liurobinn/Gimbal_Spoon/CAD/Inner_Gimbal.stl

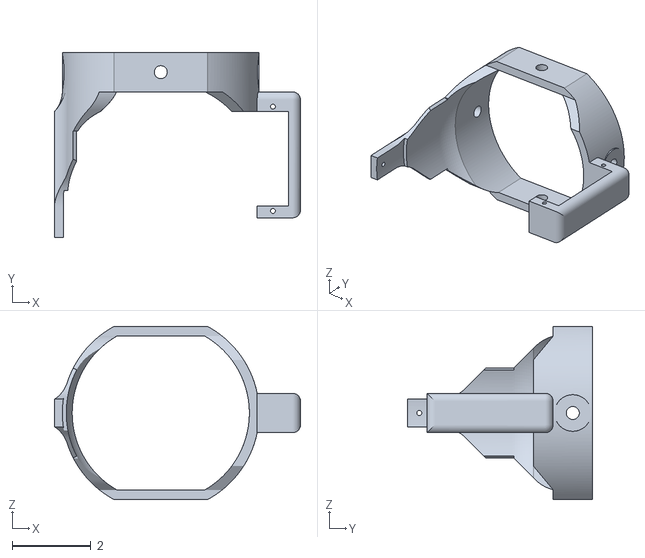
[picture p1: CAD file, 2026-05-01]
CAD/Inner_Gimbal.stl
6.25 x 4.70 x 4.40
