liurobinn/Gimbal_Spoon/CAD/Outer_Gimbal.stl

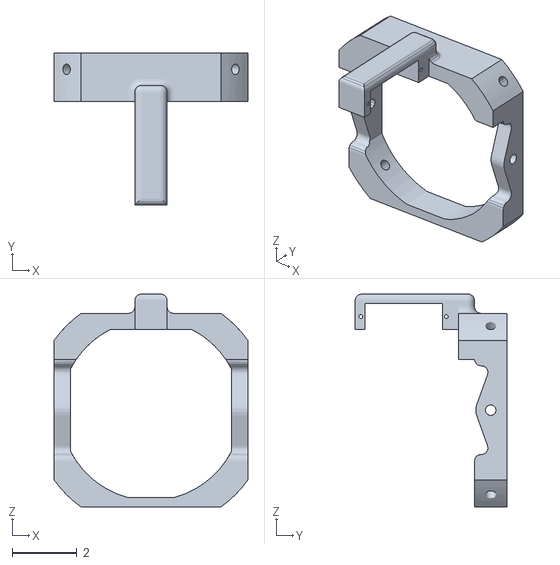
[picture p2: CAD file, 2026-05-01]
CAD/Outer_Gimbal.stl
6.00 x 4.70 x 6.60
