liurobinn/Gimbal_Spoon/CAD/Motor_Holder.stl

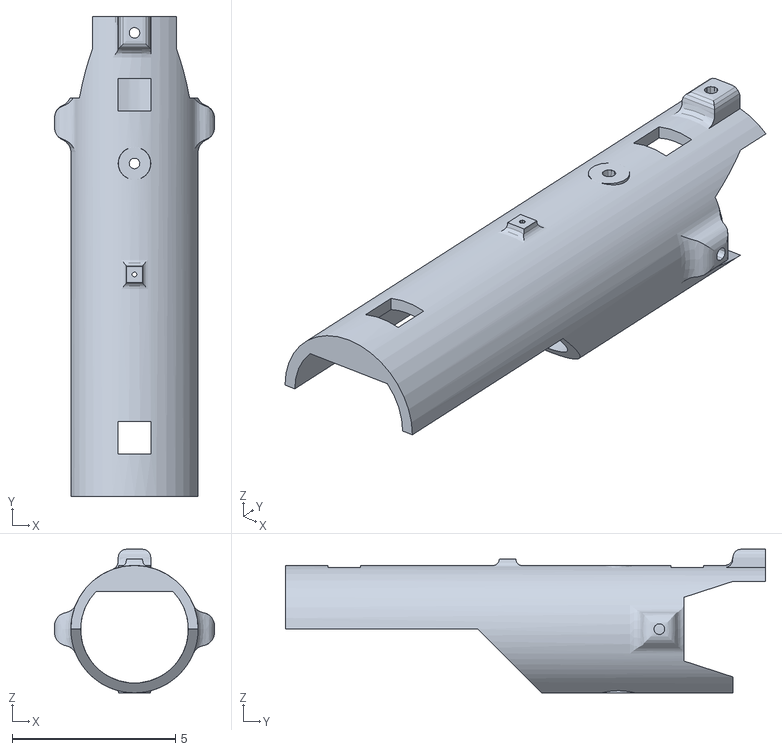
[picture p3: CAD file, 2026-05-01]
CAD/Motor_Holder.stl
4.90 x 14.7 x 4.40
