liurobinn/Gimbal_Spoon/Gimbal_Spoob_Arch.pdf

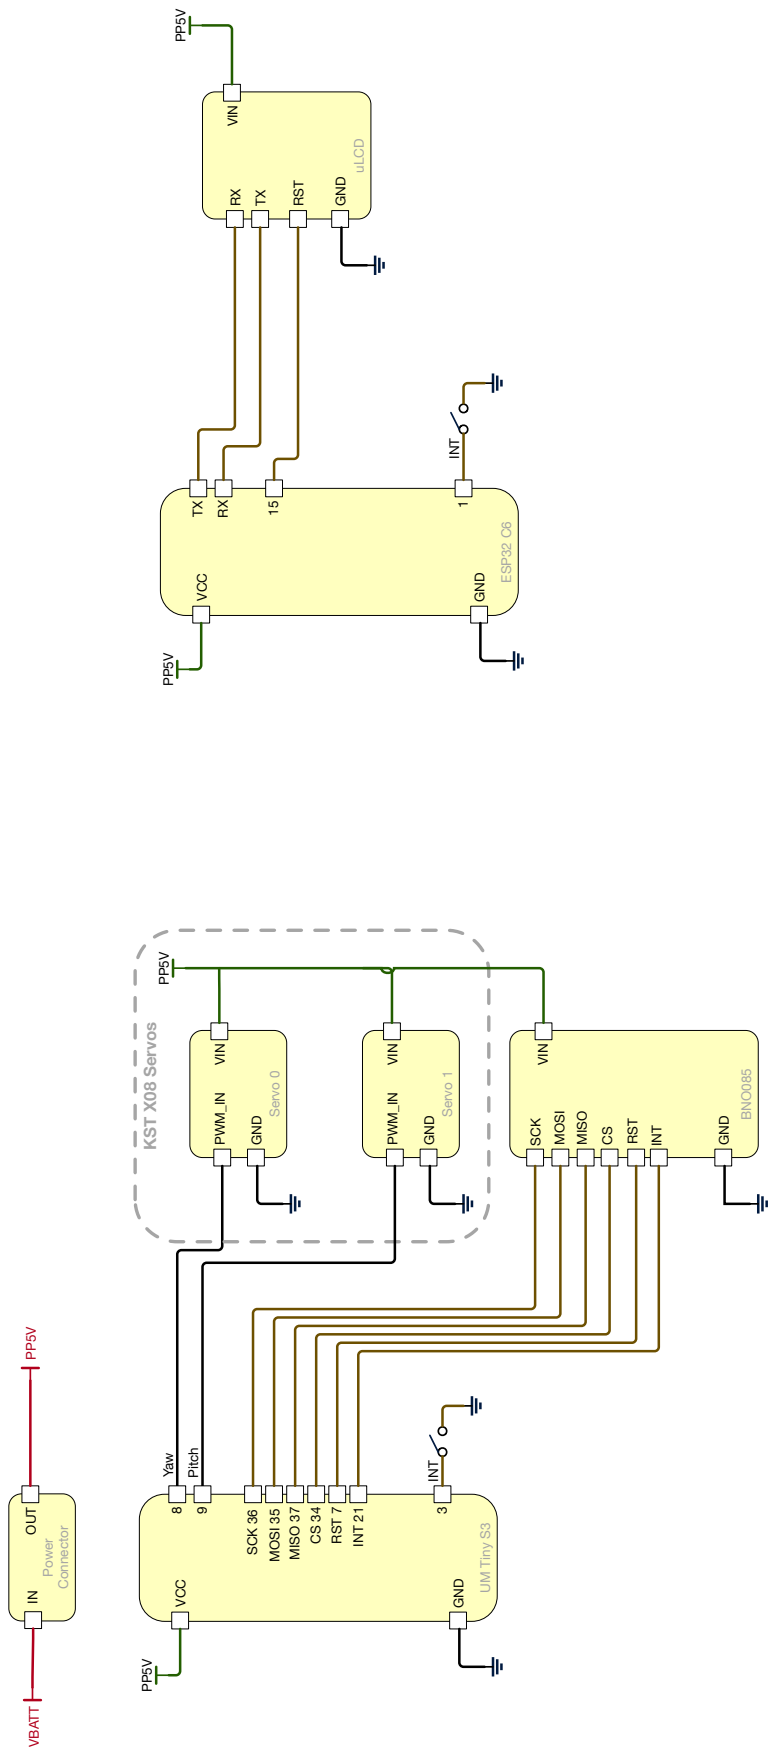
[picture p4: page 1]
Servo 0; KST X08 Servos; PWM_IN; GND; VIN; Servo 1; UM Tiny S3; VCC; SCK 36; MOSI 35; MISO 37; Yaw; Pitch; Power; Connector; RST 7; INT 21; BNO085; SCK; MOSI; MISO; RST; INT; ESP32 C6; 1 INT; uLCD

IN OUT VBATT PP5V
